LabZDjee/DiatonicScoreToneGenerator/schematics.pdf

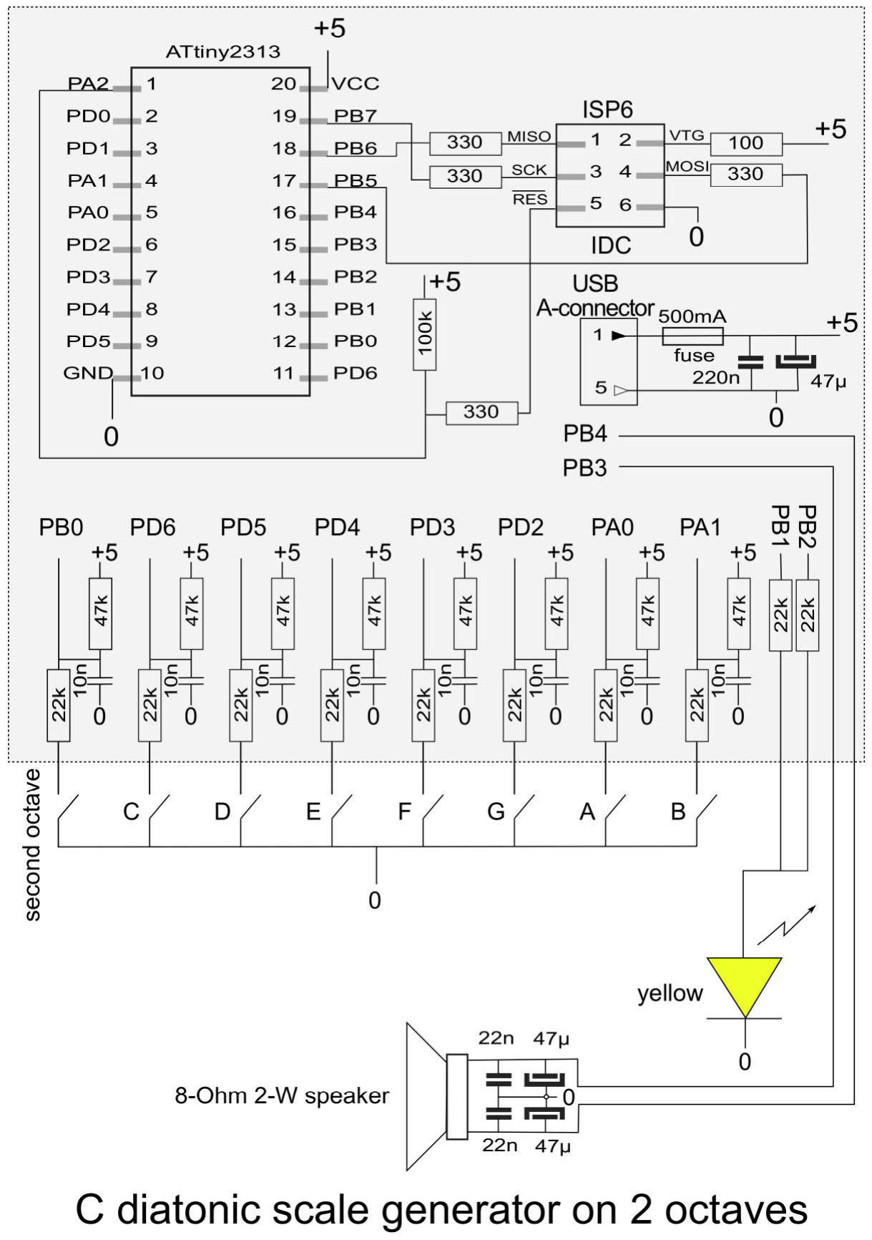
[picture p3: page 1]
